ShrihariNarayan/ttsky26d-sar-adc/docs/top_routes.png

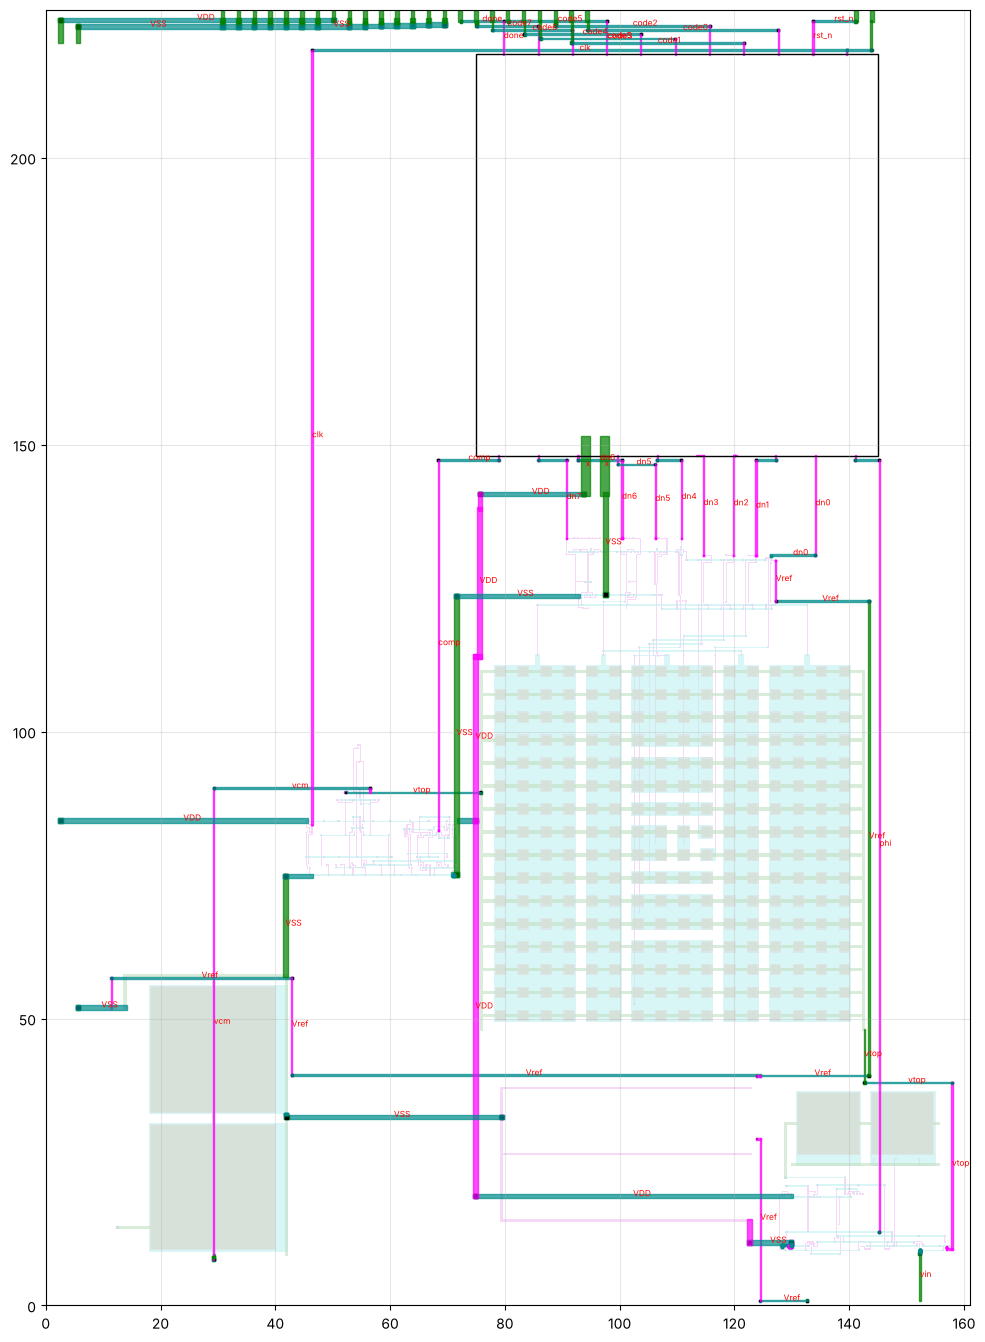
docs/top_routes.png
