ShrihariNarayan/ttsky26d-sar-adc/mag/gen/top/order.txt

vtop,vcm,vin,Vref,phi,comp,clk,rst_n,dn7,dn6,dn5,dn4,dn3,dn2,dn1,dn0,done,code7,code6,code5,code4,code3,code2,code1,code0,VDD,VSS
