ShrihariNarayan/ttsky26d-sar-adc/sim/adc_core_pex_v4.spice

* adc_core_pex.spice -- post-layout (C-only PEX, Magic) netlist of the full tile analog core,
* generated from tt_um_shriharinarayan_sar_adc by mk_core.py. Pin order = xschem adc_core.
* NGSPICE file created from tt_um_shriharinarayan_sar_adc.ext - technology: sky130A

.subckt sky130_fd_pr__nfet_01v8_34VMYE B D S G
X0 S G D B sky130_fd_pr__nfet_01v8 ad=0.29 pd=2.58 as=0.29 ps=2.58 w=1 l=0.15
C0 D S 0.08701f
C1 G S 0.02676f
C2 G D 0.02676f
C3 S B 0.25019f
C4 D B 0.25019f
.ends

.subckt sky130_fd_pr__nfet_01v8_JSF6K7 B D S G
X0 S G D B sky130_fd_pr__nfet_01v8 ad=1.16 pd=8.58 as=1.16 ps=8.58 w=4 l=0.15
C0 D S 0.3443f
C1 G S 0.06815f
C2 G D 0.06815f
C3 S B 0.47525f
C4 D B 0.47525f
.ends

.subckt sky130_fd_pr__pfet_01v8_7HN6Y2 B D S G VSUBS
X0 S G D B sky130_fd_pr__pfet_01v8 ad=0.29 pd=2.58 as=0.29 ps=2.58 w=1 l=0.15
C0 G D 0.02568f
C1 B D 0.06826f
C2 D S 0.08701f
C3 B G 0.22722f
C4 G S 0.02568f
C5 B S 0.06826f
C6 S VSUBS 0.08163f
C7 D VSUBS 0.08163f
C8 B VSUBS 1.13906f
.ends

.subckt sky130_fd_pr__pfet_01v8_VJT448 B D S G VSUBS
X0 S G D B sky130_fd_pr__pfet_01v8 ad=0.58 pd=4.58 as=0.58 ps=4.58 w=2 l=0.15
C0 G D 0.04023f
C1 B D 0.12129f
C2 D S 0.17277f
C3 B G 0.23095f
C4 G S 0.04023f
C5 B S 0.12129f
C6 S VSUBS 0.10779f
C7 D VSUBS 0.10779f
C8 B VSUBS 1.46341f
.ends

.subckt sky130_fd_pr__nfet_01v8_NK2ZG9 B D S G
X0 S G D B sky130_fd_pr__nfet_01v8 ad=0.58 pd=4.58 as=0.58 ps=4.58 w=2 l=0.15
C0 D S 0.17277f
C1 G S 0.0414f
C2 G D 0.0414f
C3 S B 0.32587f
C4 D B 0.32587f
.ends

.subckt sky130_fd_pr__cap_mim_m3_1_QUBC75 C2 C1 VSUBS
X0 C1 C2 sky130_fd_pr__cap_mim_m3_1 l=11 w=11
X1 C1 C2 sky130_fd_pr__cap_mim_m3_1 l=11 w=11
C0 C2 C1 22.5661f
C1 C2 VSUBS 9.82634f
.ends

.subckt bootstrap_switch phi vin vout M9/G M9/D MIP/D M8/G M8/S VDD VSS
XM10 VSS M14/S VSS MIP/D sky130_fd_pr__nfet_01v8_34VMYE
XM11 VSS vin vout M9/G sky130_fd_pr__nfet_01v8_34VMYE
XM12 VSS VSS M9/D MIP/D sky130_fd_pr__nfet_01v8_34VMYE
XM14 VSS M9/G M14/S VDD sky130_fd_pr__nfet_01v8_JSF6K7
XM15 VSS M8/G M9/D phi sky130_fd_pr__nfet_01v8_34VMYE
XM16 VDD M8/G VDD phi VSS sky130_fd_pr__pfet_01v8_7HN6Y2
XMIN VSS MIP/D VSS phi sky130_fd_pr__nfet_01v8_34VMYE
XM3 M8/S M8/S VDD M9/G VSS sky130_fd_pr__pfet_01v8_VJT448
XMIP VDD MIP/D VDD phi VSS sky130_fd_pr__pfet_01v8_VJT448
XM8 M8/S M9/G M8/S M8/G VSS sky130_fd_pr__pfet_01v8_VJT448
XM9 VSS M9/D vin M9/G sky130_fd_pr__nfet_01v8_NK2ZG9
XC2 M9/D M8/S VSS sky130_fd_pr__cap_mim_m3_1_QUBC75
C0 vin vout 0.02333f
C1 MIP/D M9/G 0.01865f
C2 phi M9/G 0.62528f
C3 VDD M14/S 0.03539f
C4 VDD M8/S 0.31139f
C5 VDD MIP/D 0.23362f
C6 VDD phi 0.45297f
C7 M9/D M9/G 0.08006f
C8 MIP/D M14/S 0.41663f
C9 VDD M9/D 0.02585f
C10 phi M14/S 0.02116f
C11 M8/S phi 0.13512f
C12 vin M9/G 0.08072f
C13 phi MIP/D 0.15759f
C14 M8/G M9/G 0.31053f
C15 M8/S M9/D 0.30946f
C16 M8/G VDD 0.2697f
C17 phi M9/D 0.13792f
C18 M8/G M8/S 0.34008f
C19 VDD M9/G 0.4759f
C20 M8/G phi 0.20328f
C21 vin M9/D 0.05376f
C22 M9/G M14/S 0.09618f
C23 M8/S M9/G 0.45599f
C24 M8/G M9/D 0.29653f
C25 VDD VSS 0.4137f
C26 vin VSS 0.69586f
C27 M8/S VSS 0.39355f
C28 MIP/D VSS 2.42943f
C29 phi VSS 1.62164f
C30 M8/G VSS 1.14838f
C31 M9/D VSS 1.90668f
C32 M14/S VSS 0.71207f
C33 M9/G VSS 1.83168f
C34 vout VSS 0.05157f
.ends

.subckt sky130_fd_pr__cap_mim_m3_1_LFDY3D C2 C1 VSUBS
X0 C1 C2 sky130_fd_pr__cap_mim_m3_1 l=30 w=30
C0 C1 C2 78.2652f
C1 C2 VSUBS 21.49611f
.ends

.subckt sky130_fd_pr__nfet_01v8_5K744B B D0 G0 S1 G1 D2 G2 S3 G3 D4 G4 S5 G5 a_3145_n1000#
X0 a_3145_n1000# G5 S5 B sky130_fd_pr__nfet_01v8 ad=2.9 pd=20.58 as=1.45 ps=10.29 w=10 l=5
X1 D4 G3 S3 B sky130_fd_pr__nfet_01v8 ad=1.45 pd=10.29 as=1.45 ps=10.29 w=10 l=5
X2 S1 G0 D0 B sky130_fd_pr__nfet_01v8 ad=1.45 pd=10.29 as=2.9 ps=20.58 w=10 l=5
X3 S3 G2 D2 B sky130_fd_pr__nfet_01v8 ad=1.45 pd=10.29 as=1.45 ps=10.29 w=10 l=5
X4 S5 G4 D4 B sky130_fd_pr__nfet_01v8 ad=1.45 pd=10.29 as=1.45 ps=10.29 w=10 l=5
X5 D2 G1 S1 B sky130_fd_pr__nfet_01v8 ad=1.45 pd=10.29 as=1.45 ps=10.29 w=10 l=5
C0 G4 D4 0.84307f
C1 G0 D0 0.84307f
C2 G4 G5 0.05269f
C3 S1 D2 0.06802f
C4 G2 G1 0.05269f
C5 G0 G1 0.05269f
C6 a_3145_n1000# S5 0.06802f
C7 S3 G3 0.84307f
C8 G3 G2 0.05269f
C9 G0 S1 0.84307f
C10 S5 D4 0.06802f
C11 G3 D4 0.84307f
C12 S5 G4 0.84307f
C13 G3 G4 0.05269f
C14 S5 G5 0.84307f
C15 S3 D2 0.06802f
C16 G2 D2 0.84307f
C17 S1 D0 0.06802f
C18 S1 G1 0.84307f
C19 S3 G2 0.84307f
C20 S3 D4 0.06802f
C21 a_3145_n1000# G5 0.84307f
C22 D2 G1 0.84307f
C23 S5 B 2.03595f
C24 D4 B 2.00106f
C25 S3 B 2.00084f
C26 D2 B 2.00106f
C27 S1 B 2.03595f
C28 D0 B 1.80064f
C29 a_3145_n1000# B 1.80064f
.ends

.subckt decap2 vcm VSSB Vref VSS
XCV0 VSSB vcm VSS sky130_fd_pr__cap_mim_m3_1_LFDY3D
XCV1 VSSB vcm VSS sky130_fd_pr__cap_mim_m3_1_LFDY3D
XCV2 VSSB vcm VSS sky130_fd_pr__cap_mim_m3_1_LFDY3D
XMD0 VSS VSS Vref VSS Vref VSS Vref VSS Vref VSS Vref VSS Vref VSS sky130_fd_pr__nfet_01v8_5K744B
XMD1 VSS VSS Vref VSS Vref VSS Vref VSS Vref VSS Vref VSS Vref VSS sky130_fd_pr__nfet_01v8_5K744B
XMD2 VSS VSS Vref VSS Vref VSS Vref VSS Vref VSS Vref VSS Vref VSS sky130_fd_pr__nfet_01v8_5K744B
XMD4 VSS VSS Vref VSS Vref VSS Vref VSS Vref VSS Vref VSS Vref VSS sky130_fd_pr__nfet_01v8_5K744B
XMD3 VSS VSS Vref VSS Vref VSS Vref VSS Vref VSS Vref VSS Vref VSS sky130_fd_pr__nfet_01v8_5K744B
XMD5 VSS VSS Vref VSS Vref VSS Vref VSS Vref VSS Vref VSS Vref VSS sky130_fd_pr__nfet_01v8_5K744B
XMD6 VSS VSS Vref VSS Vref VSS Vref VSS Vref VSS Vref VSS Vref VSS sky130_fd_pr__nfet_01v8_5K744B
XMD7 VSS VSS Vref VSS Vref VSS Vref VSS Vref VSS Vref VSS Vref VSS sky130_fd_pr__nfet_01v8_5K744B
XMD8 VSS VSS Vref VSS Vref VSS Vref VSS Vref VSS Vref VSS Vref VSS sky130_fd_pr__nfet_01v8_5K744B
XMD9 VSS VSS Vref VSS Vref VSS Vref VSS Vref VSS Vref VSS Vref VSS sky130_fd_pr__nfet_01v8_5K744B
C0 VSSB vcm 0.36405f
C1 Vref VSSB 69.33811f
C2 Vref vcm 6.94261f
C3 Vref VSS 16.22182f
C4 vcm VSS 6.07362f
C5 VSSB VSS 61.91421f
.ends

.subckt sky130_fd_pr__pfet_01v8_lvt_TEQ27F B D S G VSUBS
X0 S G D B sky130_fd_pr__pfet_01v8_lvt ad=0.29 pd=2.58 as=0.29 ps=2.58 w=1 l=0.35
C0 B G 0.2243f
C1 G S 0.02786f
C2 G D 0.02786f
C3 B S 0.0758f
C4 B D 0.0758f
C5 D S 0.06058f
C6 S VSUBS 0.08159f
C7 D VSUBS 0.08159f
C8 B VSUBS 1.22649f
.ends

.subckt sky130_fd_pr__nfet_01v8_PHAC7Z B D S G
X0 S G D B sky130_fd_pr__nfet_01v8 ad=0.145 pd=1.58 as=0.145 ps=1.58 w=0.5 l=0.15
C0 G D 0.0184f
C1 D S 0.04413f
C2 G S 0.0184f
C3 S B 0.21137f
C4 D B 0.21137f
.ends

.subckt sky130_fd_pr__pfet_01v8_lvt_DQLGWQ B D S G VSUBS
X0 S G D B sky130_fd_pr__pfet_01v8_lvt ad=1.16 pd=8.58 as=1.16 ps=8.58 w=4 l=0.35
C0 B G 0.22873f
C1 G S 0.10872f
C2 G D 0.10872f
C3 B S 0.246f
C4 B D 0.246f
C5 D S 0.23983f
C6 S VSUBS 0.15438f
C7 D VSUBS 0.15438f
C8 B VSUBS 2.27054f
.ends

.subckt sky130_fd_pr__pfet_01v8_lvt_EXY38E B D0 G0 S1 G1 a_99_n400# VSUBS
X0 a_99_n400# G1 S1 B sky130_fd_pr__pfet_01v8_lvt ad=1.16 pd=8.58 as=0.58 ps=4.29 w=4 l=0.35
X1 S1 G0 D0 B sky130_fd_pr__pfet_01v8_lvt ad=0.58 pd=4.29 as=1.16 ps=8.58 w=4 l=0.35
C0 a_99_n400# B 0.246f
C1 B G1 0.19252f
C2 B G0 0.19252f
C3 B S1 0.08953f
C4 D0 G0 0.10872f
C5 S1 D0 0.23983f
C6 a_99_n400# G1 0.10872f
C7 G0 G1 0.05517f
C8 a_99_n400# S1 0.23983f
C9 S1 G1 0.10872f
C10 B D0 0.246f
C11 S1 G0 0.10872f
C12 S1 VSUBS 0.06111f
C13 D0 VSUBS 0.14023f
C14 B VSUBS 2.784f
C15 a_99_n400# VSUBS 0.14023f
.ends

.subckt sky130_fd_pr__pfet_01v8_lvt_65C8BA B D0 G0 S1 G1 D2 G2 S3 G3 a_227_n400# VSUBS
X0 S1 G0 D0 B sky130_fd_pr__pfet_01v8_lvt ad=0.58 pd=4.29 as=1.16 ps=8.58 w=4 l=0.35
X1 a_227_n400# G3 S3 B sky130_fd_pr__pfet_01v8_lvt ad=1.16 pd=8.58 as=0.58 ps=4.29 w=4 l=0.35
X2 S3 G2 D2 B sky130_fd_pr__pfet_01v8_lvt ad=0.58 pd=4.29 as=0.58 ps=4.29 w=4 l=0.35
X3 D2 G1 S1 B sky130_fd_pr__pfet_01v8_lvt ad=0.58 pd=4.29 as=0.58 ps=4.29 w=4 l=0.35
C0 B D0 0.246f
C1 D2 G1 0.10872f
C2 a_227_n400# B 0.246f
C3 a_227_n400# S3 0.23983f
C4 B G1 0.15546f
C5 D2 S1 0.23983f
C6 B G0 0.19133f
C7 B S1 0.08953f
C8 B G3 0.19133f
C9 S3 G3 0.10872f
C10 G2 G1 0.05517f
C11 G3 G2 0.05517f
C12 D0 G0 0.10872f
C13 S1 D0 0.23983f
C14 D2 B 0.08953f
C15 D2 S3 0.23983f
C16 B S3 0.08953f
C17 G0 G1 0.05517f
C18 S1 G1 0.10872f
C19 a_227_n400# G3 0.10872f
C20 S1 G0 0.10872f
C21 D2 G2 0.10872f
C22 B G2 0.15546f
C23 S3 G2 0.10872f
C24 S3 VSUBS 0.04695f
C25 D2 VSUBS 0.0328f
C26 S1 VSUBS 0.04695f
C27 D0 VSUBS 0.14023f
C28 B VSUBS 3.81442f
C29 a_227_n400# VSUBS 0.14023f
.ends

.subckt sky130_fd_pr__nfet_01v8_ZXU89W B D0 G0 S1 G1 a_63_n400#
X0 a_63_n400# G1 S1 B sky130_fd_pr__nfet_01v8 ad=1.24 pd=8.62 as=0.66 ps=4.33 w=4 l=0.15
X1 S1 G0 D0 B sky130_fd_pr__nfet_01v8 ad=0.66 pd=4.33 as=1.24 ps=8.62 w=4 l=0.15
C0 G1 S1 0.05779f
C1 G0 D0 0.05779f
C2 a_63_n400# G1 0.05779f
C3 D0 S1 0.32431f
C4 G0 S1 0.05779f
C5 a_63_n400# S1 0.32431f
C6 S1 B 0.1906f
C7 D0 B 0.41609f
C8 a_63_n400# B 0.41609f
.ends

.subckt sky130_fd_pr__pfet_01v8_lvt_HGBDVL B D0 G0 S1 G1 D2 G2 S3 G3 D4 G4 S5 G5 D6
+ G6 S7 G7 a_483_n400# VSUBS
X0 S3 G2 D2 B sky130_fd_pr__pfet_01v8_lvt ad=0.58 pd=4.29 as=0.58 ps=4.29 w=4 l=0.35
X1 D6 G5 S5 B sky130_fd_pr__pfet_01v8_lvt ad=0.58 pd=4.29 as=0.58 ps=4.29 w=4 l=0.35
X2 D2 G1 S1 B sky130_fd_pr__pfet_01v8_lvt ad=0.58 pd=4.29 as=0.58 ps=4.29 w=4 l=0.35
X3 S5 G4 D4 B sky130_fd_pr__pfet_01v8_lvt ad=0.58 pd=4.29 as=0.58 ps=4.29 w=4 l=0.35
X4 S7 G6 D6 B sky130_fd_pr__pfet_01v8_lvt ad=0.58 pd=4.29 as=0.58 ps=4.29 w=4 l=0.35
X5 a_483_n400# G7 S7 B sky130_fd_pr__pfet_01v8_lvt ad=1.16 pd=8.58 as=0.58 ps=4.29 w=4 l=0.35
X6 D4 G3 S3 B sky130_fd_pr__pfet_01v8_lvt ad=0.58 pd=4.29 as=0.58 ps=4.29 w=4 l=0.35
X7 S1 G0 D0 B sky130_fd_pr__pfet_01v8_lvt ad=0.58 pd=4.29 as=1.16 ps=8.58 w=4 l=0.35
C0 S3 G2 0.10872f
C1 a_483_n400# S7 0.23983f
C2 D2 G2 0.10872f
C3 B G2 0.154f
C4 S7 B 0.08953f
C5 D2 S1 0.23983f
C6 S1 B 0.08953f
C7 D6 S7 0.23983f
C8 S3 G3 0.10872f
C9 G0 G1 0.05517f
C10 B G3 0.15376f
C11 S5 B 0.08953f
C12 S3 D4 0.23983f
C13 D6 S5 0.23983f
C14 G1 G2 0.05517f
C15 S1 G1 0.10872f
C16 B D4 0.08953f
C17 B G5 0.154f
C18 S7 G6 0.10872f
C19 B G4 0.15376f
C20 D6 G5 0.10872f
C21 G0 S1 0.10872f
C22 B D0 0.246f
C23 a_483_n400# G7 0.10872f
C24 B G7 0.19095f
C25 G5 G6 0.05517f
C26 G3 G2 0.05517f
C27 D2 S3 0.23983f
C28 S3 B 0.08953f
C29 a_483_n400# B 0.246f
C30 D2 B 0.08953f
C31 G6 G7 0.05517f
C32 D6 B 0.08953f
C33 G0 D0 0.10872f
C34 G3 D4 0.10872f
C35 S5 D4 0.23983f
C36 S5 G5 0.10872f
C37 S1 D0 0.23983f
C38 D2 G1 0.10872f
C39 G1 B 0.15478f
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
C48 S7 VSUBS 0.04695f
C49 D6 VSUBS 0.0328f
C50 S5 VSUBS 0.0328f
C51 D4 VSUBS 0.0328f
C52 S3 VSUBS 0.0328f
C53 D2 VSUBS 0.0328f
C54 S1 VSUBS 0.04695f
C55 D0 VSUBS 0.14023f
C56 B VSUBS 5.88006f
C57 a_483_n400# VSUBS 0.14023f
.ends

.subckt sky130_fd_pr__nfet_01v8_TB4QGU B D0 G0 S1 G1 D2 G2 S3 G3 a_159_n400#
X0 S3 G2 D2 B sky130_fd_pr__nfet_01v8 ad=0.66 pd=4.33 as=0.66 ps=4.33 w=4 l=0.15
X1 S1 G0 D0 B sky130_fd_pr__nfet_01v8 ad=0.66 pd=4.33 as=1.24 ps=8.62 w=4 l=0.15
X2 D2 G1 S1 B sky130_fd_pr__nfet_01v8 ad=0.66 pd=4.33 as=0.66 ps=4.33 w=4 l=0.15
X3 a_159_n400# G3 S3 B sky130_fd_pr__nfet_01v8 ad=1.24 pd=8.62 as=0.66 ps=4.33 w=4 l=0.15
C0 G0 S1 0.05779f
C1 G1 G3 0.01248f
C2 D0 S1 0.32431f
C3 a_159_n400# G3 0.05779f
C4 S3 G3 0.05779f
C5 G0 G2 0.01248f
C6 G1 S1 0.05779f
C7 D2 S1 0.32431f
C8 D2 G1 0.05779f
C9 D2 S3 0.32431f
C10 G2 D2 0.05779f
C11 a_159_n400# S3 0.32431f
C12 G2 S3 0.05779f
C13 G0 D0 0.05779f
C14 S3 B 0.16676f
C15 D2 B 0.1611f
C16 S1 B 0.16676f
C17 D0 B 0.407f
C18 a_159_n400# B 0.407f
.ends

.subckt cdac dn2 dn5 dn6 dn7 vtop VDD dn4 MP7/D6 MN5/D dn1 dn3 MP6/D2 Vref dn0 VSS
XMP0 Vref MP0/D Vref dn0 VSS sky130_fd_pr__pfet_01v8_lvt_TEQ27F
XMP1 Vref MP1/D Vref dn1 VSS sky130_fd_pr__pfet_01v8_lvt_TEQ27F
XMN0 VSS MP0/D VSS dn0 sky130_fd_pr__nfet_01v8_PHAC7Z
XMP2 Vref MP2/D Vref dn2 VSS sky130_fd_pr__pfet_01v8_lvt_TEQ27F
XMN1 VSS MP1/D VSS dn1 sky130_fd_pr__nfet_01v8_PHAC7Z
XMP3 Vref MP3/D Vref dn3 VSS sky130_fd_pr__pfet_01v8_lvt_TEQ27F
XMN2 VSS MP2/D VSS dn2 sky130_fd_pr__nfet_01v8_PHAC7Z
XMP4 Vref MP4/D Vref dn4 VSS sky130_fd_pr__pfet_01v8_lvt_DQLGWQ
XMN3 VSS MP3/D VSS dn3 sky130_fd_pr__nfet_01v8_PHAC7Z
XMP5 Vref MN5/D dn5 Vref dn5 MN5/D VSS sky130_fd_pr__pfet_01v8_lvt_EXY38E
XMP6 Vref MP6/D2 dn6 Vref dn6 MP6/D2 dn6 Vref dn6 MP6/D2 VSS sky130_fd_pr__pfet_01v8_lvt_65C8BA
XMN4 VSS MP4/D VSS dn4 sky130_fd_pr__nfet_01v8_NK2ZG9
XMN5 VSS MN5/D VSS dn5 sky130_fd_pr__nfet_01v8_JSF6K7
XMN6 VSS MP6/D2 dn6 VSS dn6 MP6/D2 sky130_fd_pr__nfet_01v8_ZXU89W
XMP7 Vref MP7/D6 dn7 Vref dn7 MP7/D6 dn7 Vref dn7 MP7/D6 dn7 Vref dn7 MP7/D6 dn7 Vref
+ dn7 MP7/D6 VSS sky130_fd_pr__pfet_01v8_lvt_HGBDVL
XMN7 VSS MP7/D6 dn7 VSS dn7 MP7/D6 dn7 VSS dn7 MP7/D6 sky130_fd_pr__nfet_01v8_TB4QGU
X0 vtop MN5/D sky130_fd_pr__cap_mim_m3_1 l=2 w=2
X1 vtop MP3/D sky130_fd_pr__cap_mim_m3_1 l=2 w=2
X2 vtop MP6/D2 sky130_fd_pr__cap_mim_m3_1 l=2 w=2
X3 vtop MP7/D6 sky130_fd_pr__cap_mim_m3_1 l=2 w=2
X4 vtop MN5/D sky130_fd_pr__cap_mim_m3_1 l=2 w=2
X5 vtop MP7/D6 sky130_fd_pr__cap_mim_m3_1 l=2 w=2
X6 vtop MP7/D6 sky130_fd_pr__cap_mim_m3_1 l=2 w=2
X7 vtop MP7/D6 sky130_fd_pr__cap_mim_m3_1 l=2 w=2
X8 vtop MP6/D2 sky130_fd_pr__cap_mim_m3_1 l=2 w=2
X9 vtop MP4/D sky130_fd_pr__cap_mim_m3_1 l=2 w=2
X10 vtop MP7/D6 sky130_fd_pr__cap_mim_m3_1 l=2 w=2
X11 vtop MP6/D2 sky130_fd_pr__cap_mim_m3_1 l=2 w=2
X12 vtop MP7/D6 sky130_fd_pr__cap_mim_m3_1 l=2 w=2
X13 vtop MP6/D2 sky130_fd_pr__cap_mim_m3_1 l=2 w=2
X14 vtop MP6/D2 sky130_fd_pr__cap_mim_m3_1 l=2 w=2
X15 vtop MN5/D sky130_fd_pr__cap_mim_m3_1 l=2 w=2
X16 vtop MN5/D sky130_fd_pr__cap_mim_m3_1 l=2 w=2
X17 vtop MP3/D sky130_fd_pr__cap_mim_m3_1 l=2 w=2
X18 vtop MP7/D6 sky130_fd_pr__cap_mim_m3_1 l=2 w=2
X19 vtop MN5/D sky130_fd_pr__cap_mim_m3_1 l=2 w=2
X20 vtop MP7/D6 sky130_fd_pr__cap_mim_m3_1 l=2 w=2
X21 vtop MP4/D sky130_fd_pr__cap_mim_m3_1 l=2 w=2
X22 vtop MP6/D2 sky130_fd_pr__cap_mim_m3_1 l=2 w=2
X23 vtop MP7/D6 sky130_fd_pr__cap_mim_m3_1 l=2 w=2
X24 vtop MP7/D6 sky130_fd_pr__cap_mim_m3_1 l=2 w=2
X25 vtop MP7/D6 sky130_fd_pr__cap_mim_m3_1 l=2 w=2
X26 vtop MP7/D6 sky130_fd_pr__cap_mim_m3_1 l=2 w=2
X27 vtop MN5/D sky130_fd_pr__cap_mim_m3_1 l=2 w=2
X28 vtop MP7/D6 sky130_fd_pr__cap_mim_m3_1 l=2 w=2
X29 vtop MP7/D6 sky130_fd_pr__cap_mim_m3_1 l=2 w=2
X30 vtop MP7/D6 sky130_fd_pr__cap_mim_m3_1 l=2 w=2
X31 vtop MP6/D2 sky130_fd_pr__cap_mim_m3_1 l=2 w=2
X32 vtop MP7/D6 sky130_fd_pr__cap_mim_m3_1 l=2 w=2
X33 vtop VSS sky130_fd_pr__cap_mim_m3_1 l=2 w=2
X34 vtop MP6/D2 sky130_fd_pr__cap_mim_m3_1 l=2 w=2
X35 vtop MN5/D sky130_fd_pr__cap_mim_m3_1 l=2 w=2
X36 vtop MP7/D6 sky130_fd_pr__cap_mim_m3_1 l=2 w=2
X37 vtop MP7/D6 sky130_fd_pr__cap_mim_m3_1 l=2 w=2
X38 vtop MP7/D6 sky130_fd_pr__cap_mim_m3_1 l=2 w=2
X39 vtop MP7/D6 sky130_fd_pr__cap_mim_m3_1 l=2 w=2
X40 vtop MP3/D sky130_fd_pr__cap_mim_m3_1 l=2 w=2
X41 vtop MN5/D sky130_fd_pr__cap_mim_m3_1 l=2 w=2
X42 vtop MP7/D6 sky130_fd_pr__cap_mim_m3_1 l=2 w=2
X43 vtop MP6/D2 sky130_fd_pr__cap_mim_m3_1 l=2 w=2
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
C85 dn4 VSS 0.32146f
C86 MP7/D6 VSS 38.97458f
C87 dn7 VSS 1.24142f
C88 Vref VSS -0.57381f
C89 MP6/D2 VSS 16.35544f
C90 dn6 VSS 0.84104f
C91 MN5/D VSS 37.63082f
C92 MP4/D VSS 5.63123f
C93 MP3/D VSS 4.06072f
C94 MP2/D VSS 2.86201f
C95 MP1/D VSS 3.45233f
C96 MP0/D VSS 3.95734f
.ends

.subckt sky130_fd_pr__nfet_01v8_WLECUA B D0 G0 S1 G1 D2 G2 S3 G3 D4 G4 S5 G5 D6 G6
+ S7 G7 a_4203_n1000#
X0 S7 G6 D6 B sky130_fd_pr__nfet_01v8 ad=1.45 pd=10.29 as=1.45 ps=10.29 w=10 l=5
X1 S5 G4 D4 B sky130_fd_pr__nfet_01v8 ad=1.45 pd=10.29 as=1.45 ps=10.29 w=10 l=5
X2 D2 G1 S1 B sky130_fd_pr__nfet_01v8 ad=1.45 pd=10.29 as=1.45 ps=10.29 w=10 l=5
X3 D4 G3 S3 B sky130_fd_pr__nfet_01v8 ad=1.45 pd=10.29 as=1.45 ps=10.29 w=10 l=5
X4 a_4203_n1000# G7 S7 B sky130_fd_pr__nfet_01v8 ad=2.9 pd=20.58 as=1.45 ps=10.29 w=10 l=5
X5 S1 G0 D0 B sky130_fd_pr__nfet_01v8 ad=1.45 pd=10.29 as=2.9 ps=20.58 w=10 l=5
X6 D6 G5 S5 B sky130_fd_pr__nfet_01v8 ad=1.45 pd=10.29 as=1.45 ps=10.29 w=10 l=5
X7 S3 G2 D2 B sky130_fd_pr__nfet_01v8 ad=1.45 pd=10.29 as=1.45 ps=10.29 w=10 l=5
C0 G1 D2 0.84307f
C1 D6 G6 0.84307f
C2 G0 D0 0.84307f
C3 S5 G4 0.84307f
C4 D4 S5 0.06802f
C5 S1 D0 0.06802f
C6 S3 G2 0.84307f
C7 S1 D2 0.06802f
C8 D6 S5 0.06802f
C9 G1 G0 0.05269f
C10 G3 S3 0.84307f
C11 G1 S1 0.84307f
C12 G5 G4 0.05269f
C13 G7 a_4203_n1000# 0.84307f
C14 G3 G2 0.05269f
C15 S7 a_4203_n1000# 0.06802f
C16 D4 S3 0.06802f
C17 S3 D2 0.06802f
C18 G5 G6 0.05269f
C19 G0 S1 0.84307f
C20 G2 D2 0.84307f
C21 G7 S7 0.84307f
C22 D6 G5 0.84307f
C23 G3 G4 0.05269f
C24 G3 D4 0.84307f
C25 G2 G1 0.05269f
C26 D4 G4 0.84307f
C27 G5 S5 0.84307f
C28 G7 G6 0.05269f
C29 S7 G6 0.84307f
C30 D6 S7 0.06802f
C31 S7 B 2.03595f
C32 D6 B 2.00106f
C33 S5 B 2.00084f
C34 D4 B 2.00084f
C35 S3 B 2.00084f
C36 D2 B 2.00106f
C37 S1 B 2.03595f
C38 D0 B 1.80064f
C39 a_4203_n1000# B 1.80064f
.ends

.subckt decap Vref VSS
XMC0 VSS VSS Vref VSS Vref VSS Vref VSS Vref VSS Vref VSS Vref VSS Vref VSS Vref VSS
+ sky130_fd_pr__nfet_01v8_WLECUA
XMC1 VSS VSS Vref VSS Vref VSS Vref VSS Vref VSS Vref VSS Vref VSS Vref VSS Vref VSS
+ sky130_fd_pr__nfet_01v8_WLECUA
XMC2 VSS VSS Vref VSS Vref VSS Vref VSS Vref VSS Vref VSS Vref VSS Vref VSS Vref VSS
+ sky130_fd_pr__nfet_01v8_WLECUA
C0 Vref VSS 6.7344f
.ends

.subckt sky130_fd_pr__res_xhigh_po_1p41_BDUJGV B R1 R2
X0 R1 R2 B sky130_fd_pr__res_xhigh_po_1p41 l=36
C0 R2 B 0.66301f
C1 R1 B 0.66301f
.ends
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
