ShrihariNarayan/ttsky26d-sar-adc/sim_scripts/montecarlo/sub_E1.spice

.subckt comparator_sa inp VDD inn clk VSS X Y
*.ipin inp
*.ipin inn
*.ipin clk
*.opin X
*.opin Y
*.iopin VDD
*.iopin VSS
XM7 T ckb VDD VDD sky130_fd_pr__pfet_01v8 L=0.15 W=4 nf=1 ad=1.16 as=1.16 pd=8.58 ps=8.58 nrd=0.0725 nrs=0.0725 sa=0 sb=0 sd=0
+ mult=1
XM1 P inp T T sky130_fd_pr__pfet_01v8_lvt L=0.5 W=8 nf=4 ad=1.16 as=1.74 pd=9.16 ps=13.74 nrd=0.03625 nrs=0.03625 sa=0 sb=0 sd=0
+ mult=1
XM2 Q inn T T sky130_fd_pr__pfet_01v8_lvt L=0.5 W=8 nf=4 ad=1.16 as=1.74 pd=9.16 ps=13.74 nrd=0.03625 nrs=0.03625 sa=0 sb=0 sd=0
+ mult=1
XM3 X Y P VDD sky130_fd_pr__pfet_01v8 L=0.15 W=2 nf=1 ad=0.58 as=0.58 pd=4.58 ps=4.58 nrd=0.145 nrs=0.145 sa=0 sb=0 sd=0 mult=1
XM4 Y X Q VDD sky130_fd_pr__pfet_01v8 L=0.15 W=2 nf=1 ad=0.58 as=0.58 pd=4.58 ps=4.58 nrd=0.145 nrs=0.145 sa=0 sb=0 sd=0 mult=1
XM6 Y X VSS VSS sky130_fd_pr__nfet_01v8 L=0.15 W=1 nf=1 ad=0.29 as=0.29 pd=2.58 ps=2.58 nrd=0.29 nrs=0.29 sa=0 sb=0 sd=0 mult=1
XM5 X Y VSS VSS sky130_fd_pr__nfet_01v8 L=0.15 W=1 nf=1 ad=0.29 as=0.29 pd=2.58 ps=2.58 nrd=0.29 nrs=0.29 sa=0 sb=0 sd=0 mult=1
XS4 Y ckb VSS VSS sky130_fd_pr__nfet_01v8 L=0.6 W=2 nf=1 ad=0.145 as=0.145 pd=1.58 ps=1.58 nrd=0.58 nrs=0.58 sa=0 sb=0 sd=0
+ mult=1
XS2 Q ckb VSS VSS sky130_fd_pr__nfet_01v8 L=0.6 W=2 nf=1 ad=0.145 as=0.145 pd=1.58 ps=1.58 nrd=0.58 nrs=0.58 sa=0 sb=0 sd=0
+ mult=1
XS3 X ckb VSS VSS sky130_fd_pr__nfet_01v8 L=0.6 W=2 nf=1 ad=0.145 as=0.145 pd=1.58 ps=1.58 nrd=0.58 nrs=0.58 sa=0 sb=0 sd=0
+ mult=1
XS1 P ckb VSS VSS sky130_fd_pr__nfet_01v8 L=0.6 W=2 nf=1 ad=0.145 as=0.145 pd=1.58 ps=1.58 nrd=0.58 nrs=0.58 sa=0 sb=0 sd=0
+ mult=1
XMIN ckb clk VSS VSS sky130_fd_pr__nfet_01v8 L=0.15 W=1 nf=1 ad=0.29 as=0.29 pd=2.58 ps=2.58 nrd=0.29 nrs=0.29 sa=0 sb=0 sd=0
+ mult=1
XMIP ckb clk VDD VDD sky130_fd_pr__pfet_01v8 L=0.15 W=2 nf=1 ad=0.58 as=0.58 pd=4.58 ps=4.58 nrd=0.145 nrs=0.145 sa=0 sb=0 sd=0
+ mult=1
.ends
