ShrihariNarayan/ttsky26d-sar-adc/mag/gen/signoff/work/lay_gds.spice

* NGSPICE file created from tt_um_shriharinarayan_sar_adc.ext - technology: sky130A

.subckt sky130_fd_pr__nfet_01v8_34VMYE G D B S
X0 S G D B sky130_fd_pr__nfet_01v8 ad=0.29 pd=2.58 as=0.29 ps=2.58 w=1 l=0.15
.ends

.subckt sky130_fd_pr__nfet_01v8_JSF6K7 G D B S
X0 S G D B sky130_fd_pr__nfet_01v8 ad=1.16 pd=8.58 as=1.16 ps=8.58 w=4 l=0.15
.ends

.subckt sky130_fd_pr__pfet_01v8_7HN6Y2 G D B S
X0 S G D B sky130_fd_pr__pfet_01v8 ad=0.29 pd=2.58 as=0.29 ps=2.58 w=1 l=0.15
.ends

.subckt sky130_fd_pr__pfet_01v8_VJT448 G D B S
X0 S G D B sky130_fd_pr__pfet_01v8 ad=0.58 pd=4.58 as=0.58 ps=4.58 w=2 l=0.15
.ends

.subckt sky130_fd_pr__nfet_01v8_NK2ZG9 G D B S
X0 S G D B sky130_fd_pr__nfet_01v8 ad=0.58 pd=4.58 as=0.58 ps=4.58 w=2 l=0.15
.ends

.subckt sky130_fd_pr__cap_mim_m3_1_QUBC75 C1 C2
X0 C1 C2 sky130_fd_pr__cap_mim_m3_1 l=11 w=11
X1 C1 C2 sky130_fd_pr__cap_mim_m3_1 l=11 w=11
.ends

.subckt bootstrap_switch phi vin vout VDD VSS
XM10 MIP/D M14/S VSS VSS sky130_fd_pr__nfet_01v8_34VMYE
XM11 M9/G vin VSS vout sky130_fd_pr__nfet_01v8_34VMYE
XM12 MIP/D VSS VSS M9/D sky130_fd_pr__nfet_01v8_34VMYE
XM14 VDD M9/G VSS M14/S sky130_fd_pr__nfet_01v8_JSF6K7
XM15 phi M8/G VSS M9/D sky130_fd_pr__nfet_01v8_34VMYE
XM16 phi M8/G VDD VDD sky130_fd_pr__pfet_01v8_7HN6Y2
XMIN phi MIP/D VSS VSS sky130_fd_pr__nfet_01v8_34VMYE
XM3 M9/G M8/S M8/S VDD sky130_fd_pr__pfet_01v8_VJT448
XMIP phi MIP/D VDD VDD sky130_fd_pr__pfet_01v8_VJT448
XM8 M8/G M9/G M8/S M8/S sky130_fd_pr__pfet_01v8_VJT448
XM9 M9/G M9/D VSS vin sky130_fd_pr__nfet_01v8_NK2ZG9
XC2 M8/S M9/D sky130_fd_pr__cap_mim_m3_1_QUBC75
.ends

.subckt sky130_fd_pr__cap_mim_m3_1_LFDY3D C1 C2
X0 C1 C2 sky130_fd_pr__cap_mim_m3_1 l=30 w=30
.ends

.subckt sky130_fd_pr__nfet_01v8_5K744B B a_3145_n1000# D4 D2 G5 G4 D0 G3 G2 G1 G0
+ S5 S3 S1
X0 a_3145_n1000# G5 S5 B sky130_fd_pr__nfet_01v8 ad=2.9 pd=20.58 as=1.45 ps=10.29 w=10 l=5
X1 D4 G3 S3 B sky130_fd_pr__nfet_01v8 ad=1.45 pd=10.29 as=1.45 ps=10.29 w=10 l=5
X2 S1 G0 D0 B sky130_fd_pr__nfet_01v8 ad=1.45 pd=10.29 as=2.9 ps=20.58 w=10 l=5
X3 S3 G2 D2 B sky130_fd_pr__nfet_01v8 ad=1.45 pd=10.29 as=1.45 ps=10.29 w=10 l=5
X4 S5 G4 D4 B sky130_fd_pr__nfet_01v8 ad=1.45 pd=10.29 as=1.45 ps=10.29 w=10 l=5
X5 D2 G1 S1 B sky130_fd_pr__nfet_01v8 ad=1.45 pd=10.29 as=1.45 ps=10.29 w=10 l=5
.ends

.subckt decap2 Vref VSSB vcm VSS
XCV0 vcm VSSB sky130_fd_pr__cap_mim_m3_1_LFDY3D
XCV1 vcm VSSB sky130_fd_pr__cap_mim_m3_1_LFDY3D
XCV2 vcm VSSB sky130_fd_pr__cap_mim_m3_1_LFDY3D
XMD0 VSS VSS VSS VSS Vref Vref VSS Vref Vref Vref Vref VSS VSS VSS sky130_fd_pr__nfet_01v8_5K744B
XMD1 VSS VSS VSS VSS Vref Vref VSS Vref Vref Vref Vref VSS VSS VSS sky130_fd_pr__nfet_01v8_5K744B
XMD2 VSS VSS VSS VSS Vref Vref VSS Vref Vref Vref Vref VSS VSS VSS sky130_fd_pr__nfet_01v8_5K744B
XMD3 VSS VSS VSS VSS Vref Vref VSS Vref Vref Vref Vref VSS VSS VSS sky130_fd_pr__nfet_01v8_5K744B
XMD4 VSS VSS VSS VSS Vref Vref VSS Vref Vref Vref Vref VSS VSS VSS sky130_fd_pr__nfet_01v8_5K744B
XMD5 VSS VSS VSS VSS Vref Vref VSS Vref Vref Vref Vref VSS VSS VSS sky130_fd_pr__nfet_01v8_5K744B
XMD6 VSS VSS VSS VSS Vref Vref VSS Vref Vref Vref Vref VSS VSS VSS sky130_fd_pr__nfet_01v8_5K744B
XMD7 VSS VSS VSS VSS Vref Vref VSS Vref Vref Vref Vref VSS VSS VSS sky130_fd_pr__nfet_01v8_5K744B
XMD8 VSS VSS VSS VSS Vref Vref VSS Vref Vref Vref Vref VSS VSS VSS sky130_fd_pr__nfet_01v8_5K744B
XMD9 VSS VSS VSS VSS Vref Vref VSS Vref Vref Vref Vref VSS VSS VSS sky130_fd_pr__nfet_01v8_5K744B
.ends

.subckt sky130_fd_pr__pfet_01v8_lvt_TEQ27F G D B S
X0 S G D B sky130_fd_pr__pfet_01v8_lvt ad=0.29 pd=2.58 as=0.29 ps=2.58 w=1 l=0.35
.ends

.subckt sky130_fd_pr__nfet_01v8_PHAC7Z G D B S
X0 S G D B sky130_fd_pr__nfet_01v8 ad=0.145 pd=1.58 as=0.145 ps=1.58 w=0.5 l=0.15
.ends

.subckt sky130_fd_pr__pfet_01v8_lvt_DQLGWQ G D B S
X0 S G D B sky130_fd_pr__pfet_01v8_lvt ad=1.16 pd=8.58 as=1.16 ps=8.58 w=4 l=0.35
.ends

.subckt sky130_fd_pr__pfet_01v8_lvt_EXY38E a_99_n400# B D0 G1 G0 S1
X0 a_99_n400# G1 S1 B sky130_fd_pr__pfet_01v8_lvt ad=1.16 pd=8.58 as=0.58 ps=4.29 w=4 l=0.35
X1 S1 G0 D0 B sky130_fd_pr__pfet_01v8_lvt ad=0.58 pd=4.29 as=1.16 ps=8.58 w=4 l=0.35
.ends

.subckt sky130_fd_pr__pfet_01v8_lvt_65C8BA B D2 D0 G3 G2 G1 G0 a_227_n400# S3 S1
X0 S1 G0 D0 B sky130_fd_pr__pfet_01v8_lvt ad=0.58 pd=4.29 as=1.16 ps=8.58 w=4 l=0.35
X1 a_227_n400# G3 S3 B sky130_fd_pr__pfet_01v8_lvt ad=1.16 pd=8.58 as=0.58 ps=4.29 w=4 l=0.35
X2 S3 G2 D2 B sky130_fd_pr__pfet_01v8_lvt ad=0.58 pd=4.29 as=0.58 ps=4.29 w=4 l=0.35
X3 D2 G1 S1 B sky130_fd_pr__pfet_01v8_lvt ad=0.58 pd=4.29 as=0.58 ps=4.29 w=4 l=0.35
.ends

.subckt sky130_fd_pr__pfet_01v8_lvt_HGBDVL a_483_n400# B D6 D4 G7 G6 D2 G5 G4 D0 G3
+ G2 G1 G0 S7 S5 S3 S1
X0 S3 G2 D2 B sky130_fd_pr__pfet_01v8_lvt ad=0.58 pd=4.29 as=0.58 ps=4.29 w=4 l=0.35
X1 D6 G5 S5 B sky130_fd_pr__pfet_01v8_lvt ad=0.58 pd=4.29 as=0.58 ps=4.29 w=4 l=0.35
X2 D2 G1 S1 B sky130_fd_pr__pfet_01v8_lvt ad=0.58 pd=4.29 as=0.58 ps=4.29 w=4 l=0.35
X3 S5 G4 D4 B sky130_fd_pr__pfet_01v8_lvt ad=0.58 pd=4.29 as=0.58 ps=4.29 w=4 l=0.35
X4 S7 G6 D6 B sky130_fd_pr__pfet_01v8_lvt ad=0.58 pd=4.29 as=0.58 ps=4.29 w=4 l=0.35
X5 a_483_n400# G7 S7 B sky130_fd_pr__pfet_01v8_lvt ad=1.16 pd=8.58 as=0.58 ps=4.29 w=4 l=0.35
X6 D4 G3 S3 B sky130_fd_pr__pfet_01v8_lvt ad=0.58 pd=4.29 as=0.58 ps=4.29 w=4 l=0.35
X7 S1 G0 D0 B sky130_fd_pr__pfet_01v8_lvt ad=0.58 pd=4.29 as=1.16 ps=8.58 w=4 l=0.35
.ends

.subckt sky130_fd_pr__nfet_01v8_ZXU89W B a_63_n400# D0 G1 G0 S1
X0 a_63_n400# G1 S1 B sky130_fd_pr__nfet_01v8 ad=1.24 pd=8.62 as=0.66 ps=4.33 w=4 l=0.15
X1 S1 G0 D0 B sky130_fd_pr__nfet_01v8 ad=0.66 pd=4.33 as=1.24 ps=8.62 w=4 l=0.15
.ends

.subckt sky130_fd_pr__nfet_01v8_TB4QGU B D2 D0 G3 G2 G1 G0 S3 S1 a_159_n400#
X0 S3 G2 D2 B sky130_fd_pr__nfet_01v8 ad=0.66 pd=4.33 as=0.66 ps=4.33 w=4 l=0.15
X1 S1 G0 D0 B sky130_fd_pr__nfet_01v8 ad=0.66 pd=4.33 as=1.24 ps=8.62 w=4 l=0.15
X2 D2 G1 S1 B sky130_fd_pr__nfet_01v8 ad=0.66 pd=4.33 as=0.66 ps=4.33 w=4 l=0.15
X3 a_159_n400# G3 S3 B sky130_fd_pr__nfet_01v8 ad=1.24 pd=8.62 as=0.66 ps=4.33 w=4 l=0.15
.ends

.subckt cdac dn2 dn5 dn6 dn7 vtop VDD dn4 dn1 dn3 dn0 Vref VSS
XMP0 dn0 MP0/D Vref Vref sky130_fd_pr__pfet_01v8_lvt_TEQ27F
XMP1 dn1 MP1/D Vref Vref sky130_fd_pr__pfet_01v8_lvt_TEQ27F
XMP2 dn2 MP2/D Vref Vref sky130_fd_pr__pfet_01v8_lvt_TEQ27F
XMN0 dn0 MP0/D VSS VSS sky130_fd_pr__nfet_01v8_PHAC7Z
XMP3 dn3 MP3/D Vref Vref sky130_fd_pr__pfet_01v8_lvt_TEQ27F
XMN1 dn1 MP1/D VSS VSS sky130_fd_pr__nfet_01v8_PHAC7Z
XMP4 dn4 MP4/D Vref Vref sky130_fd_pr__pfet_01v8_lvt_DQLGWQ
XMN2 dn2 MP2/D VSS VSS sky130_fd_pr__nfet_01v8_PHAC7Z
XMP5 MN5/D Vref MN5/D dn5 dn5 Vref sky130_fd_pr__pfet_01v8_lvt_EXY38E
XMN3 dn3 MP3/D VSS VSS sky130_fd_pr__nfet_01v8_PHAC7Z
XMN4 dn4 MP4/D VSS VSS sky130_fd_pr__nfet_01v8_NK2ZG9
XMP6 Vref MP6/D2 MP6/D2 dn6 dn6 dn6 dn6 MP6/D2 Vref Vref sky130_fd_pr__pfet_01v8_lvt_65C8BA
XMP7 MP7/D6 Vref MP7/D6 MP7/D6 dn7 dn7 MP7/D6 dn7 dn7 MP7/D6 dn7 dn7 dn7 dn7 Vref
+ Vref Vref Vref sky130_fd_pr__pfet_01v8_lvt_HGBDVL
XMN6 VSS MP6/D2 MP6/D2 dn6 dn6 VSS sky130_fd_pr__nfet_01v8_ZXU89W
XMN5 dn5 MN5/D VSS VSS sky130_fd_pr__nfet_01v8_JSF6K7
XMN7 VSS MP7/D6 MP7/D6 dn7 dn7 dn7 dn7 VSS VSS MP7/D6 sky130_fd_pr__nfet_01v8_TB4QGU
X0 vtop MN5/D sky130_fd_pr__cap_mim_m3_1 l=2 w=2
X1 vtop MP3/D sky130_fd_pr__cap_mim_m3_1 l=2 w=2
X2 vtop MP6/D2 sky130_fd_pr__cap_mim_m3_1 l=2 w=2
X3 vtop MP7/D6 sky130_fd_pr__cap_mim_m3_1 l=2 w=2
X4 vtop MN5/D sky130_fd_pr__cap_mim_m3_1 l=2 w=2
X5 vtop MP7/D6 sky130_fd_pr__cap_mim_m3_1 l=2 w=2
X6 vtop MP7/D6 sky130_fd_pr__cap_mim_m3_1 l=2 w=2
X7 vtop MP7/D6 sky130_fd_pr__cap_mim_m3_1 l=2 w=2
X8 vtop MP6/D2 sky130_fd_pr__cap_mim_m3_1 l=2 w=2
X9 vtop MP4/D sky130_fd_pr__cap_mim_m3_1 l=2 w=2
X10 vtop MP7/D6 sky130_fd_pr__cap_mim_m3_1 l=2 w=2
X11 vtop MP6/D2 sky130_fd_pr__cap_mim_m3_1 l=2 w=2
X12 vtop MP7/D6 sky130_fd_pr__cap_mim_m3_1 l=2 w=2
X13 vtop MP6/D2 sky130_fd_pr__cap_mim_m3_1 l=2 w=2
X14 vtop MP6/D2 sky130_fd_pr__cap_mim_m3_1 l=2 w=2
X15 vtop MN5/D sky130_fd_pr__cap_mim_m3_1 l=2 w=2
X16 vtop MN5/D sky130_fd_pr__cap_mim_m3_1 l=2 w=2
X17 vtop MP3/D sky130_fd_pr__cap_mim_m3_1 l=2 w=2
X18 vtop MP7/D6 sky130_fd_pr__cap_mim_m3_1 l=2 w=2
X19 vtop MN5/D sky130_fd_pr__cap_mim_m3_1 l=2 w=2
X20 vtop MP7/D6 sky130_fd_pr__cap_mim_m3_1 l=2 w=2
X21 vtop MP4/D sky130_fd_pr__cap_mim_m3_1 l=2 w=2
X22 vtop MP6/D2 sky130_fd_pr__cap_mim_m3_1 l=2 w=2
X23 vtop MP7/D6 sky130_fd_pr__cap_mim_m3_1 l=2 w=2
X24 vtop MP7/D6 sky130_fd_pr__cap_mim_m3_1 l=2 w=2
X25 vtop MP7/D6 sky130_fd_pr__cap_mim_m3_1 l=2 w=2
X26 vtop MP7/D6 sky130_fd_pr__cap_mim_m3_1 l=2 w=2
X27 vtop MN5/D sky130_fd_pr__cap_mim_m3_1 l=2 w=2
X28 vtop MP7/D6 sky130_fd_pr__cap_mim_m3_1 l=2 w=2
X29 vtop MP7/D6 sky130_fd_pr__cap_mim_m3_1 l=2 w=2
X30 vtop MP7/D6 sky130_fd_pr__cap_mim_m3_1 l=2 w=2
X31 vtop MP6/D2 sky130_fd_pr__cap_mim_m3_1 l=2 w=2
X32 vtop MP7/D6 sky130_fd_pr__cap_mim_m3_1 l=2 w=2
X33 vtop VSS sky130_fd_pr__cap_mim_m3_1 l=2 w=2
X34 vtop MP6/D2 sky130_fd_pr__cap_mim_m3_1 l=2 w=2
X35 vtop MN5/D sky130_fd_pr__cap_mim_m3_1 l=2 w=2
X36 vtop MP7/D6 sky130_fd_pr__cap_mim_m3_1 l=2 w=2
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
X234 vtop MP6/D2 sky130_fd_pr__cap_mim_m3_1 l=2 w=2
X235 vtop MP4/D sky130_fd_pr__cap_mim_m3_1 l=2 w=2
X236 vtop MP7/D6 sky130_fd_pr__cap_mim_m3_1 l=2 w=2
X237 vtop MP7/D6 sky130_fd_pr__cap_mim_m3_1 l=2 w=2
X238 vtop MP7/D6 sky130_fd_pr__cap_mim_m3_1 l=2 w=2
X239 vtop MP6/D2 sky130_fd_pr__cap_mim_m3_1 l=2 w=2
X240 vtop MP7/D6 sky130_fd_pr__cap_mim_m3_1 l=2 w=2
X241 vtop MP7/D6 sky130_fd_pr__cap_mim_m3_1 l=2 w=2
X242 vtop MP6/D2 sky130_fd_pr__cap_mim_m3_1 l=2 w=2
X243 vtop MP7/D6 sky130_fd_pr__cap_mim_m3_1 l=2 w=2
X244 vtop MP1/D sky130_fd_pr__cap_mim_m3_1 l=2 w=2
X245 vtop MP6/D2 sky130_fd_pr__cap_mim_m3_1 l=2 w=2
X246 vtop MP7/D6 sky130_fd_pr__cap_mim_m3_1 l=2 w=2
X247 vtop MP7/D6 sky130_fd_pr__cap_mim_m3_1 l=2 w=2
X248 vtop MP7/D6 sky130_fd_pr__cap_mim_m3_1 l=2 w=2
X249 vtop MP6/D2 sky130_fd_pr__cap_mim_m3_1 l=2 w=2
X250 vtop MP6/D2 sky130_fd_pr__cap_mim_m3_1 l=2 w=2
X251 vtop MN5/D sky130_fd_pr__cap_mim_m3_1 l=2 w=2
X252 vtop MP7/D6 sky130_fd_pr__cap_mim_m3_1 l=2 w=2
X253 vtop MP7/D6 sky130_fd_pr__cap_mim_m3_1 l=2 w=2
X254 vtop MP6/D2 sky130_fd_pr__cap_mim_m3_1 l=2 w=2
X255 vtop MP7/D6 sky130_fd_pr__cap_mim_m3_1 l=2 w=2
.ends

.subckt sky130_fd_sc_hd__buf_16 VNB VPB VGND VPWR A X
X0 VGND A a_109_47# VNB sky130_fd_pr__nfet_01v8 ad=0.08775 pd=0.92 as=0.08775 ps=0.92 w=0.65 l=0.15
X1 X a_109_47# VPWR VPB sky130_fd_pr__pfet_01v8_hvt ad=0.135 pd=1.27 as=0.135 ps=1.27 w=1 l=0.15
X2 VGND a_109_47# X VNB sky130_fd_pr__nfet_01v8 ad=0.08775 pd=0.92 as=0.08775 ps=0.92 w=0.65 l=0.15
X3 VGND a_109_47# X VNB sky130_fd_pr__nfet_01v8 ad=0.08775 pd=0.92 as=0.08775 ps=0.92 w=0.65 l=0.15
X4 X a_109_47# VPWR VPB sky130_fd_pr__pfet_01v8_hvt ad=0.135 pd=1.27 as=0.135 ps=1.27 w=1 l=0.15
X5 VGND a_109_47# X VNB sky130_fd_pr__nfet_01v8 ad=0.08775 pd=0.92 as=0.08775 ps=0.92 w=0.65 l=0.15
X6 VPWR a_109_47# X VPB sky130_fd_pr__pfet_01v8_hvt ad=0.135 pd=1.27 as=0.135 ps=1.27 w=1 l=0.15
X7 a_109_47# A VPWR VPB sky130_fd_pr__pfet_01v8_hvt ad=0.135 pd=1.27 as=0.135 ps=1.27 w=1 l=0.15
X8 X a_109_47# VPWR VPB sky130_fd_pr__pfet_01v8_hvt ad=0.135 pd=1.27 as=0.135 ps=1.27 w=1 l=0.15
X9 VPWR A a_109_47# VPB sky130_fd_pr__pfet_01v8_hvt ad=0.135 pd=1.27 as=0.135 ps=1.27 w=1 l=0.15
X10 X a_109_47# VGND VNB sky130_fd_pr__nfet_01v8 ad=0.08775 pd=0.92 as=0.08775 ps=0.92 w=0.65 l=0.15
X11 X a_109_47# VGND VNB sky130_fd_pr__nfet_01v8 ad=0.08775 pd=0.92 as=0.08775 ps=0.92 w=0.65 l=0.15
X12 X a_109_47# VGND VNB sky130_fd_pr__nfet_01v8 ad=0.08775 pd=0.92 as=0.08775 ps=0.92 w=0.65 l=0.15
X13 X a_109_47# VGND VNB sky130_fd_pr__nfet_01v8 ad=0.08775 pd=0.92 as=0.08775 ps=0.92 w=0.65 l=0.15
X14 a_109_47# A VPWR VPB sky130_fd_pr__pfet_01v8_hvt ad=0.135 pd=1.27 as=0.135 ps=1.27 w=1 l=0.15
X15 VPWR a_109_47# X VPB sky130_fd_pr__pfet_01v8_hvt ad=0.135 pd=1.27 as=0.135 ps=1.27 w=1 l=0.15
X16 X a_109_47# VGND VNB sky130_fd_pr__nfet_01v8 ad=0.08775 pd=0.92 as=0.08775 ps=0.92 w=0.65 l=0.15
X17 X a_109_47# VPWR VPB sky130_fd_pr__pfet_01v8_hvt ad=0.135 pd=1.27 as=0.135 ps=1.27 w=1 l=0.15
X18 VPWR A a_109_47# VPB sky130_fd_pr__pfet_01v8_hvt ad=0.135 pd=1.27 as=0.135 ps=1.27 w=1 l=0.15
X19 VPWR a_109_47# X VPB sky130_fd_pr__pfet_01v8_hvt ad=0.135 pd=1.27 as=0.135 ps=1.27 w=1 l=0.15
X20 VGND A a_109_47# VNB sky130_fd_pr__nfet_01v8 ad=0.08775 pd=0.92 as=0.08775 ps=0.92 w=0.65 l=0.15
X21 VGND A a_109_47# VNB sky130_fd_pr__nfet_01v8 ad=0.08775 pd=0.92 as=0.08775 ps=0.92 w=0.65 l=0.15
X22 VGND a_109_47# X VNB sky130_fd_pr__nfet_01v8 ad=0.08775 pd=0.92 as=0.08775 ps=0.92 w=0.65 l=0.15
X23 X a_109_47# VPWR VPB sky130_fd_pr__pfet_01v8_hvt ad=0.135 pd=1.27 as=0.135 ps=1.27 w=1 l=0.15
X24 VGND a_109_47# X VNB sky130_fd_pr__nfet_01v8 ad=0.08775 pd=0.92 as=0.08775 ps=0.92 w=0.65 l=0.15
X25 VPWR a_109_47# X VPB sky130_fd_pr__pfet_01v8_hvt ad=0.135 pd=1.27 as=0.135 ps=1.27 w=1 l=0.15
X26 VGND a_109_47# X VNB sky130_fd_pr__nfet_01v8 ad=0.08775 pd=0.92 as=0.08775 ps=0.92 w=0.65 l=0.15
X27 VPWR a_109_47# X VPB sky130_fd_pr__pfet_01v8_hvt ad=0.135 pd=1.27 as=0.135 ps=1.27 w=1 l=0.15
X28 X a_109_47# VPWR VPB sky130_fd_pr__pfet_01v8_hvt ad=0.135 pd=1.27 as=0.135 ps=1.27 w=1 l=0.15
X29 VGND a_109_47# X VNB sky130_fd_pr__nfet_01v8 ad=0.169 pd=1.82 as=0.08775 ps=0.92 w=0.65 l=0.15
X30 a_109_47# A VGND VNB sky130_fd_pr__nfet_01v8 ad=0.08775 pd=0.92 as=0.08775 ps=0.92 w=0.65 l=0.15
X31 a_109_47# A VGND VNB sky130_fd_pr__nfet_01v8 ad=0.08775 pd=0.92 as=0.08775 ps=0.92 w=0.65 l=0.15
X32 X a_109_47# VPWR VPB sky130_fd_pr__pfet_01v8_hvt ad=0.135 pd=1.27 as=0.135 ps=1.27 w=1 l=0.15
X33 VPWR a_109_47# X VPB sky130_fd_pr__pfet_01v8_hvt ad=0.135 pd=1.27 as=0.135 ps=1.27 w=1 l=0.15
X34 X a_109_47# VGND VNB sky130_fd_pr__nfet_01v8 ad=0.08775 pd=0.92 as=0.08775 ps=0.92 w=0.65 l=0.15
X35 X a_109_47# VGND VNB sky130_fd_pr__nfet_01v8 ad=0.08775 pd=0.92 as=0.08775 ps=0.92 w=0.65 l=0.15
X36 VPWR A a_109_47# VPB sky130_fd_pr__pfet_01v8_hvt ad=0.135 pd=1.27 as=0.135 ps=1.27 w=1 l=0.15
X37 X a_109_47# VPWR VPB sky130_fd_pr__pfet_01v8_hvt ad=0.135 pd=1.27 as=0.135 ps=1.27 w=1 l=0.15
X38 X a_109_47# VGND VNB sky130_fd_pr__nfet_01v8 ad=0.08775 pd=0.92 as=0.08775 ps=0.92 w=0.65 l=0.15
X39 a_109_47# A VPWR VPB sky130_fd_pr__pfet_01v8_hvt ad=0.135 pd=1.27 as=0.26 ps=2.52 w=1 l=0.15
X40 VPWR a_109_47# X VPB sky130_fd_pr__pfet_01v8_hvt ad=0.135 pd=1.27 as=0.135 ps=1.27 w=1 l=0.15
X41 VPWR a_109_47# X VPB sky130_fd_pr__pfet_01v8_hvt ad=0.26 pd=2.52 as=0.135 ps=1.27 w=1 l=0.15
X42 a_109_47# A VGND VNB sky130_fd_pr__nfet_01v8 ad=0.08775 pd=0.92 as=0.169 ps=1.82 w=0.65 l=0.15
X43 VGND a_109_47# X VNB sky130_fd_pr__nfet_01v8 ad=0.08775 pd=0.92 as=0.08775 ps=0.92 w=0.65 l=0.15
.ends

.subckt sky130_fd_sc_hd__decap_3 VPWR VGND VPB VNB
X0 VPWR VGND VPWR VPB sky130_fd_pr__pfet_01v8_hvt ad=0.2262 pd=2.26 as=0.4524 ps=4.52 w=0.87 l=0.59
X1 VGND VPWR VGND VNB sky130_fd_pr__nfet_01v8 ad=0.143 pd=1.62 as=0.286 ps=3.24 w=0.55 l=0.59
.ends

.subckt sky130_fd_sc_hd__mux2i_1 VPB VNB VGND VPWR A0 Y A1 S
X0 a_27_297# S VPWR VPB sky130_fd_pr__pfet_01v8_hvt ad=0.26 pd=2.52 as=0.3 ps=1.6 w=1 l=0.15
X1 VGND S a_283_205# VNB sky130_fd_pr__nfet_01v8 ad=0.169 pd=1.82 as=0.169 ps=1.82 w=0.65 l=0.15
X2 a_204_297# A1 Y VPB sky130_fd_pr__pfet_01v8_hvt ad=0.1975 pd=1.395 as=0.1525 ps=1.305 w=1 l=0.15
X3 a_193_47# A1 Y VNB sky130_fd_pr__nfet_01v8 ad=0.182 pd=1.86 as=0.08775 ps=0.92 w=0.65 l=0.15
X4 Y A0 a_27_297# VPB sky130_fd_pr__pfet_01v8_hvt ad=0.1525 pd=1.305 as=0.28 ps=2.56 w=1 l=0.15
X5 VPWR a_283_205# a_204_297# VPB sky130_fd_pr__pfet_01v8_hvt ad=0.3 pd=1.6 as=0.1975 ps=1.395 w=1 l=0.15
X6 VPWR S a_283_205# VPB sky130_fd_pr__pfet_01v8_hvt ad=0.26 pd=2.52 as=0.29 ps=2.58 w=1 l=0.15
X7 VGND a_283_205# a_27_47# VNB sky130_fd_pr__nfet_01v8 ad=0.08775 pd=0.92 as=0.169 ps=1.82 w=0.65 l=0.15
X8 a_193_47# S VGND VNB sky130_fd_pr__nfet_01v8 ad=0.169 pd=1.82 as=0.08775 ps=0.92 w=0.65 l=0.15
X9 Y A0 a_27_47# VNB sky130_fd_pr__nfet_01v8 ad=0.08775 pd=0.92 as=0.169 ps=1.82 w=0.65 l=0.15
.ends

.subckt sky130_fd_sc_hd__decap_4 VGND VPWR VPB VNB
X0 VPWR VGND VPWR VPB sky130_fd_pr__pfet_01v8_hvt ad=0.2262 pd=2.26 as=0.4524 ps=4.52 w=0.87 l=1.05
X1 VGND VPWR VGND VNB sky130_fd_pr__nfet_01v8 ad=0.143 pd=1.62 as=0.286 ps=3.24 w=0.55 l=1.05
.ends

.subckt sky130_fd_sc_hd__a22o_1 VPWR VGND VPB VNB B1 A1 A2 X B2
X0 VPWR A2 a_109_297# VPB sky130_fd_pr__pfet_01v8_hvt ad=0.155 pd=1.31 as=0.16 ps=1.32 w=1 l=0.15
X1 a_27_297# B1 a_109_47# VNB sky130_fd_pr__nfet_01v8 ad=0.169 pd=1.82 as=0.07475 ps=0.88 w=0.65 l=0.15
X2 VGND A2 a_373_47# VNB sky130_fd_pr__nfet_01v8 ad=0.10075 pd=0.96 as=0.11375 ps=1 w=0.65 l=0.15
X3 X a_27_297# VPWR VPB sky130_fd_pr__pfet_01v8_hvt ad=0.26 pd=2.52 as=0.155 ps=1.31 w=1 l=0.15
X4 a_27_297# B1 a_109_297# VPB sky130_fd_pr__pfet_01v8_hvt ad=0.25285 pd=2.52 as=0.135 ps=1.27 w=1 l=0.15
X5 a_109_297# A1 VPWR VPB sky130_fd_pr__pfet_01v8_hvt ad=0.16 pd=1.32 as=0.2529 ps=2.52 w=1 l=0.15
X6 a_373_47# A1 a_27_297# VNB sky130_fd_pr__nfet_01v8 ad=0.11375 pd=1 as=0.169 ps=1.82 w=0.65 l=0.15
X7 X a_27_297# VGND VNB sky130_fd_pr__nfet_01v8 ad=0.169 pd=1.82 as=0.10075 ps=0.96 w=0.65 l=0.15
X8 a_109_297# B2 a_27_297# VPB sky130_fd_pr__pfet_01v8_hvt ad=0.135 pd=1.27 as=0.26 ps=2.52 w=1 l=0.15
X9 a_109_47# B2 VGND VNB sky130_fd_pr__nfet_01v8 ad=0.07475 pd=0.88 as=0.169 ps=1.82 w=0.65 l=0.15
.ends

.subckt sky130_fd_sc_hd__inv_1 VPB VNB VGND VPWR A Y
X0 Y A VGND VNB sky130_fd_pr__nfet_01v8 ad=0.169 pd=1.82 as=0.169 ps=1.82 w=0.65 l=0.15
X1 Y A VPWR VPB sky130_fd_pr__pfet_01v8_hvt ad=0.26 pd=2.52 as=0.26 ps=2.52 w=1 l=0.15
.ends

.subckt sky130_fd_sc_hd__dlygate4sd3_1 X A VPB VNB VGND VPWR
X0 VPWR A a_49_47# VPB sky130_fd_pr__pfet_01v8_hvt ad=0.0567 pd=0.69 as=0.1092 ps=1.36 w=0.42 l=0.15
X1 VGND a_285_47# a_391_47# VNB sky130_fd_pr__nfet_01v8 ad=0.097 pd=0.975 as=0.1092 ps=1.36 w=0.42 l=0.5
X2 X a_391_47# VPWR VPB sky130_fd_pr__pfet_01v8_hvt ad=0.26 pd=2.52 as=0.14075 ps=1.325 w=1 l=0.15
X3 VGND A a_49_47# VNB sky130_fd_pr__nfet_01v8 ad=0.0567 pd=0.69 as=0.1092 ps=1.36 w=0.42 l=0.15
X4 VPWR a_285_47# a_391_47# VPB sky130_fd_pr__pfet_01v8_hvt ad=0.14075 pd=1.325 as=0.1092 ps=1.36 w=0.42 l=0.5
X5 a_285_47# a_49_47# VGND VNB sky130_fd_pr__nfet_01v8 ad=0.1092 pd=1.36 as=0.0567 ps=0.69 w=0.42 l=0.5
X6 a_285_47# a_49_47# VPWR VPB sky130_fd_pr__pfet_01v8_hvt ad=0.1092 pd=1.36 as=0.0567 ps=0.69 w=0.42 l=0.5
X7 X a_391_47# VGND VNB sky130_fd_pr__nfet_01v8 ad=0.169 pd=1.82 as=0.097 ps=0.975 w=0.65 l=0.15
.ends

.subckt sky130_ef_sc_hd__decap_12 VGND VPWR VPB VNB
X0 VPWR VGND VPWR VPB sky130_fd_pr__pfet_01v8_hvt ad=0.2262 pd=2.26 as=0.4524 ps=4.52 w=0.87 l=4.73
X1 VGND VPWR VGND VNB sky130_fd_pr__nfet_01v8 ad=0.143 pd=1.62 as=0.286 ps=3.24 w=0.55 l=4.73
.ends

.subckt sky130_fd_sc_hd__buf_4 VPWR VGND X A VPB VNB
X0 VPWR a_27_47# X VPB sky130_fd_pr__pfet_01v8_hvt ad=0.26 pd=2.52 as=0.135 ps=1.27 w=1 l=0.15
X1 X a_27_47# VPWR VPB sky130_fd_pr__pfet_01v8_hvt ad=0.135 pd=1.27 as=0.135 ps=1.27 w=1 l=0.15
X2 VPWR a_27_47# X VPB sky130_fd_pr__pfet_01v8_hvt ad=0.135 pd=1.27 as=0.135 ps=1.27 w=1 l=0.15
X3 X a_27_47# VPWR VPB sky130_fd_pr__pfet_01v8_hvt ad=0.135 pd=1.27 as=0.135 ps=1.27 w=1 l=0.15
X4 X a_27_47# VGND VNB sky130_fd_pr__nfet_01v8 ad=0.08775 pd=0.92 as=0.08775 ps=0.92 w=0.65 l=0.15
X5 X a_27_47# VGND VNB sky130_fd_pr__nfet_01v8 ad=0.08775 pd=0.92 as=0.08775 ps=0.92 w=0.65 l=0.15
X6 VGND a_27_47# X VNB sky130_fd_pr__nfet_01v8 ad=0.08775 pd=0.92 as=0.08775 ps=0.92 w=0.65 l=0.15
X7 VGND a_27_47# X VNB sky130_fd_pr__nfet_01v8 ad=0.169 pd=1.82 as=0.08775 ps=0.92 w=0.65 l=0.15
X8 VPWR A a_27_47# VPB sky130_fd_pr__pfet_01v8_hvt ad=0.135 pd=1.27 as=0.26 ps=2.52 w=1 l=0.15
X9 VGND A a_27_47# VNB sky130_fd_pr__nfet_01v8 ad=0.08775 pd=0.92 as=0.169 ps=1.82 w=0.65 l=0.15
.ends
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
