ShrihariNarayan/ttsky26d-sar-adc/verilog/gl/sar_logic.v

module sar_logic (clk,
    comp,
    done,
    phi,
    rst_n,
    VPWR,
    VGND,
    code,
    dn);
 input clk;
 input comp;
 output done;
 output phi;
 input rst_n;
 inout VPWR;
 inout VGND;
 output [7:0] code;
 output [7:0] dn;

 wire _000_;
 wire _001_;
 wire net50;
 wire net51;
 wire net52;
 wire net53;
 wire net54;
 wire net55;
 wire net56;
 wire net57;
 wire clknet_0_clk;
 wire _011_;
 wire _012_;
 wire _013_;
 wire _014_;
 wire _015_;
 wire _016_;
 wire _017_;
 wire _018_;
 wire _019_;
 wire _020_;
 wire _021_;
 wire _022_;
 wire _023_;
 wire _024_;
 wire _025_;
 wire _026_;
 wire _027_;
 wire _028_;
 wire _029_;
 wire _030_;
 wire _031_;
 wire _032_;
 wire _033_;
 wire _034_;
 wire _035_;
 wire _036_;
 wire _037_;
 wire _038_;
 wire _039_;
 wire _040_;
 wire _041_;
 wire _042_;
 wire _043_;
 wire _044_;
 wire _045_;
 wire _046_;
 wire _047_;
 wire _048_;
 wire _049_;
 wire _050_;
 wire _051_;
 wire _052_;
 wire _053_;
 wire _054_;
 wire _055_;
 wire _056_;
 wire _057_;
 wire _058_;
 wire _059_;
 wire _060_;
 wire _061_;
 wire _062_;
 wire _063_;
 wire _064_;
 wire _065_;
 wire _066_;
 wire _067_;
 wire _068_;
 wire _069_;
 wire _070_;
 wire net3;
 wire net4;
 wire net5;
 wire net6;
 wire net7;
 wire net8;
 wire net9;
 wire net10;
 wire net1;
 wire net11;
 wire net12;
 wire net13;
 wire net14;
 wire net15;
 wire net16;
 wire net17;
 wire net18;
 wire net19;
 wire net20;
 wire net2;
 wire \sel[0] ;
 wire \sel[1] ;
 wire \sel[2] ;
 wire \sel[3] ;
 wire \sel[4] ;
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
    .VPWR(VPWR),
    .X(done));
 sky130_fd_sc_hd__buf_16 wire39 (.A(net39),
    .VGND(VGND),
    .VNB(VGND),
    .VPB(VPWR),
    .VPWR(VPWR),
    .X(dn[7]));
 sky130_fd_sc_hd__buf_16 wire40 (.A(net40),
    .VGND(VGND),
    .VNB(VGND),
    .VPB(VPWR),
    .VPWR(VPWR),
    .X(code[7]));
endmodule
