ShrihariNarayan/ttsky26d-sar-adc/(commit log)

2026-10-14 S/H: TG switch + half-size dummies + 2pF MiM hold cap (schematic, symbol)
2026-10-17 S/H: double TG widths (M1 4/0.15 nf2, M2 8/0.15 nf2, dummies 2,4) to fix ~1.0V acquisition dip; add testbench + pedestal sweep
2026-10-18 S/H: bootstrapped switch (Razavi Fig.4d + M15/M16 so M8 gate never sees Vin+VDD), LVS netlist verified
2026-10-18 S/H bootstrap final: M14 W=4 (M14 Vds peak 2.03->1.83V at fs/125). All 7 corners pass: acq <=81uV, pedestal INL ~0.03 LSB, all terminal stresses <=1.87V edge-only
2026-10-20 Comparator: LVT input pair W=8 nf=4 L=0.5. CM sweep 0-1.2V passes 7 corners (worst 17ns @1.2V sf/-40; 1.5ns @1.0V)
2026-10-21 Comparator kickback tb: matched 2p/2p passes (drift <=23uV, all decisions ok); mismatch tolerance ~0.05 mV/% -> DAC top-plate C must match vhold within 10% (20% max)
2026-10-21 Comparator for fixed-Vcm CDAC architecture: std-Vt input W=8/L=0.5 (LVT dropped), reset switches 2/0.6. MC offset sigma 4.3-4.6 mV @CM 0.4-0.6; worst tdec ~3.6 ns @0.6V
2026-10-21 CDAC: 256 x 1.8um MiM unit caps (128..1 + dummy, ~2 pF), Vref/GND inverter drivers per bit. LVS netlist verified
2026-10-21 CDAC drivers: LVT PMOS L=0.35, body on Vref (std-Vt PMOS nearly off at Vsg=Vref=1V cold). Settling <2uV in 45ns at 7 corners
2026-10-21 SAR logic (verilog/rtl): 10-clk free-running, negedge, dn=code; tb passes all 256 codes + 0.600V->153. Archive MC + probe scripts
2026-10-21 Full-ADC co-sim (d_cosim): adc_mixed.cir + probes. tt codes exact in upper half; low-Vin error traced to comparator kickback (ideal comparator -> exact codes); 10pF Vref decap fixes soft-Vref part
2026-10-21 INL fix: scaled CDAC drivers (bits 7-4) + 10pF MOS Vref decap in adc_core. tt max|INL| 0.87 -> 0.12 LSB. inl_scan derives pin order from netlist
2026-10-21 Full-ADC corners: 5 corners x 3 temps, 0 missing, max|INL| <= 0.26 LSB (fs 85C); offset < 1 LSB, gain err < 1%
2026-10-21 L1: TT 1x2 tile from official DEF, met4 power stripes, pcell scatter (MiM, xhigh_po, LVT, decap nfet) for precheck; actions -> ttsky26d
2026-10-22 L4: sar_logic hardened (LibreLane, 70x70um, DRC/LVS/antenna 0, no timing/slew/cap viol, 150fF output load). MiM MC: ngspice sigma_unit 0.24%, sqrt(N) confirmed, m= not reduced; keep 1.8um unit
2026-10-22 L2 start: sar_logic re-hardened with pin order matching tile top pins (done, code[7:0], rst_n, clk); placed at (75,148)um top-right; L1 scatter removed
2026-10-24 L3 comparator: device placement (25 pcells, symmetric core, merged nwells), DRC met1.6 only (unwired gates)
2026-10-24 L3 comparator: wired by scripted router (m2/m3), DRC 0, LVS match uniquely (25 dev, 17 nets, 7 pins); std-cell views for sar_logic
2026-10-24 L3: vcm_gen, cdac (256x 2um MiM, symmetric grouped, 16 drivers), Vref decap - all DRC 0 / LVS match (verified locally); block verify script
2026-10-25 L3 bootstrap_switch: re-spaced placement (3um channels, C2 above), wired by router: DRC 0, LVS match; all 5 analog blocks verified
2026-10-25 T2/T3: full-tile assembly + routing (DRC 0, top LVS match), sar_logic re-harden, output ties, info.yaml pinout
2026-10-25 Precheck fixes: comparator latch guard-ring contacts (licon.1/.2), vcm_gen resistor pitch 4.0um (urpm/licon); re-route; PEX netlist with DC ties
2026-10-25 CDAC: notch bottom-plate m3 under vtop straps (equalise per-unit parasitic; MSB err +0.57 -> +0.27 LSB); re-route
2026-10-26 v3: route vtop/vcm off the comparator (keep-out + corridors); antenna check clean; power measurement in FFT
2026-10-27 v4: CDAC parasitic equalisation, 35 pF Vref decap, Vcm cap; Gear post-layout: ENOB ~8.0, INL <=0.16 LSB (15 corners), DNL +/-0.26; datasheet updated
